stfmygod/esp32-band-pcb/board-a-main/logs/PROMPT_step0_20260529_183550.md

Session 0 complete: board-b-sensor project setup, libraries registered, pogo pin footprint created.
