stfmygod/esp32-band-pcb/board-b-sensor/board-b-sensor.kicad_pcb

## KiCad design board-b-sensor/board-b-sensor.kicad_pcb (2026-06-14)

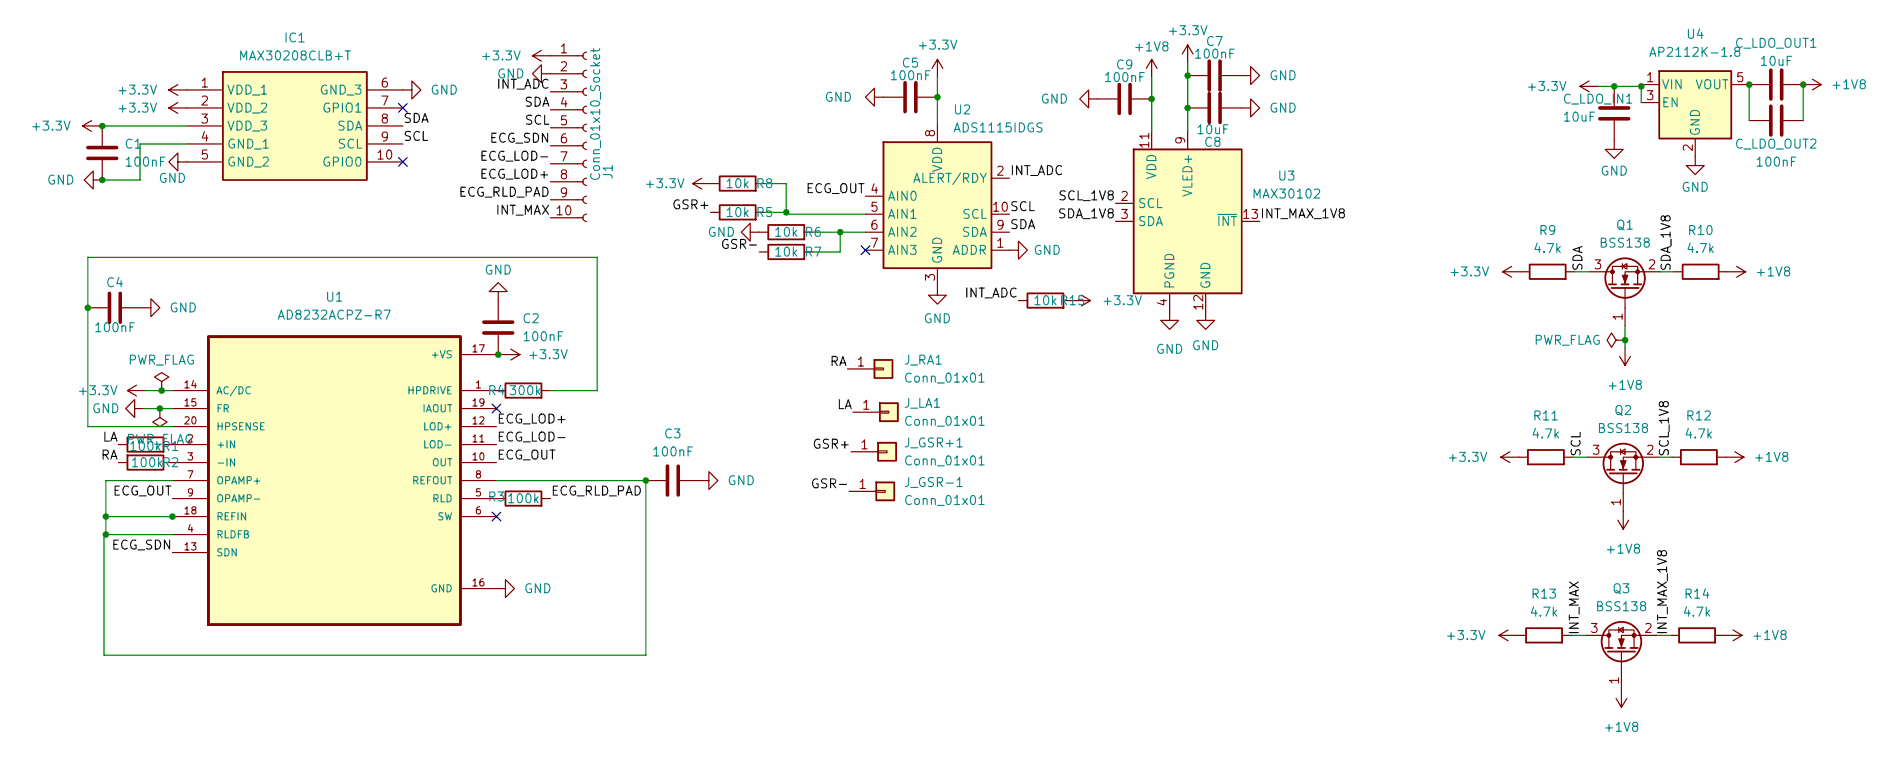
[picture p1: schematic board-b-sensor.kicad_sch]

Parts:
C1, C2, C3, C4, C5, C7, C9: 100nF; C_0402_1005Metric
C8: 10uF; C_0805_2012Metric
C_LDO_IN1: 10uF; C_0805_2012Metric
C_LDO_OUT1: 10uF; C_0805_2012Metric
C_LDO_OUT2: 100nF; C_0402_1005Metric
IC1: MAX30208CLB+T; MAX30208CLBT; Manufacturer_Part_Number MAX30208CLB+T; Mouser Part Number 700-MAX30208CLB+T
J1: Conn_01x10_Socket; FPC-SMD_10P-P0.50_XUNPU_FPC-05F-10PH15
J_GSR+1: Conn_01x01; TestPoint_Pad_D2.0mm
J_GSR-1: Conn_01x01; TestPoint_Pad_D2.0mm
J_LA1: Conn_01x01; TestPoint_Pad_D2.0mm
J_RA1: Conn_01x01; TestPoint_Pad_D2.0mm
Q1, Q2, Q3: BSS138; SOT-23
R1, R2, R3: 100k; R_0402_1005Metric
R4: 300k; R_0402_1005Metric
R5, R6, R7, R8, R15: 10k; R_0402_1005Metric
R9, R10, R11, R12, R13, R14: 4.7k; R_0402_1005Metric
U1: AD8232ACPZ-R7; QFN-20-1EP_4x4mm_P0.5mm_EP2.6x2.6mm
U2: ADS1115IDGS; TSSOP-10_3x3mm_P0.5mm
U3: MAX30102; Maxim_OLGA-14_3.3x5.6mm_P0.8mm
U4: AP2112K-1.8; SOT-23-5

Connections:
+1V8: C9.2, C_LDO_OUT1.2, C_LDO_OUT2.1, Q1.1 (G), Q2.1 (G), Q3.1 (G), R10.2, R12.2, R14.2, U3.11 (VDD)
+3.3V: C1.1, C2.2, C5.2, C7.1, C8.1, C_LDO_IN1.2, IC1.1 (VDD_1), IC1.2 (VDD_2), IC1.3 (VDD_3), J1.1, R8.1, R9.1, R11.1, R13.1, R15.2, U1.14 (AC/DC), U1.17 (+VS), U2.8 (VDD), U3.9 (VLED+), U3.10 (VLED+), U4.1 (VIN), U4.3 (EN)
/ECG_LOD+: J1.8, U1.12 (LOD+)
/ECG_LOD-: J1.7, U1.11 (LOD-)
/ECG_OUT: U1.9 (OPAMP-), U1.10 (OUT), U2.4 (AIN0)
/ECG_RLD_PAD: J1.9, R3.2
/ECG_SDN: J1.6, U1.13 (SDN)
/GSR+: J_GSR+1.1 (Pin_1_1), R5.1
/GSR-: J_GSR-1.1 (Pin_1_1), R7.1
/INT_ADC: J1.3, R15.1, U2.2 (ALERT/RDY)
/INT_MAX: J1.10, Q3.3 (D), R13.2
/INT_MAX_1V8: Q3.2 (S), R14.1, U3.13 (~INT)
/LA: J_LA1.1 (Pin_1_1), R1.1
/RA: J_RA1.1 (Pin_1_1), R2.2
/SCL: IC1.9 (SCL), J1.5, Q2.3 (D), R11.2, U2.10 (SCL)
/SCL_1V8: Q2.2 (S), R12.1, U3.2 (SCL)
/SDA: IC1.8 (SDA), J1.4, Q1.3 (D), R9.2, U2.9 (SDA)
/SDA_1V8: Q1.2 (S), R10.1, U3.3 (SDA)
GND: C1.2, C2.1, C3.2, C4.1, C5.1, C7.2, C8.2, C9.1, C_LDO_IN1.1, IC1.4 (GND_1), IC1.5 (GND_2), IC1.6 (GND_3), J1.2, R6.1, U1.15 (FR), U1.16 (GND), U2.1 (ADDR), U2.3 (GND), U3.4 (PGND), U3.12 (GND), U4.2 (GND)
unnamed: R1.2, U1.2 (+IN)
unnamed: R2.1, U1.3 (-IN)
unnamed: R4.1, U1.1 (HPDRIVE)
unnamed: C4.2, R4.2, U1.20 (HPSENSE)
unnamed: C3.1, U1.4 (RLDFB), U1.7 (OPAMP+), U1.8 (REFOUT), U1.18 (REFIN)
unnamed: R3.1, U1.5 (RLD)
unnamed: R5.2, R8.2, U2.5 (AIN1)
unnamed: R6.2, R7.2, U2.6 (AIN2)
unnamed: C_LDO_OUT1.1, C_LDO_OUT2.2, U4.5 (VOUT)

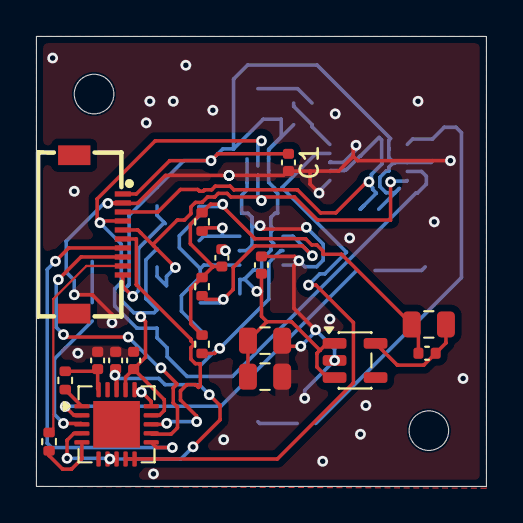
[picture p2: board board-b-sensor.kicad_pcb from above]

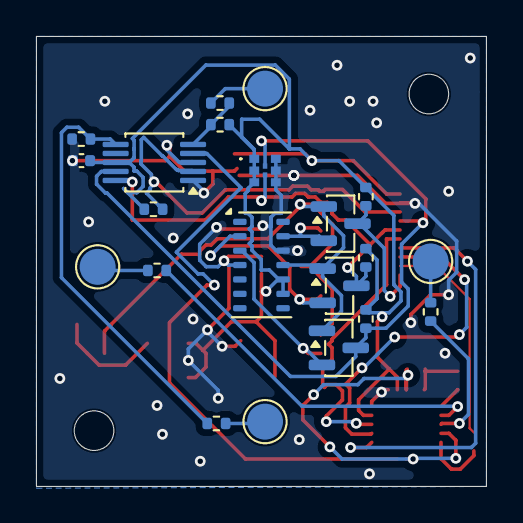
[picture p3: board board-b-sensor.kicad_pcb from below]

Board: 2 copper layers, 25.0 x 25.0 mm, 41 parts (21 on the bottom side), 28 nets.

Other parts of the board:
MountingHole1, MountingHole2: MountingHole_2.2mm_M2
