stfmygod/esp32-band-pcb/board-a-main/board-a-main.kicad_pcb

## KiCad design board-a-main/board-a-main.kicad_pcb (2026-06-02)

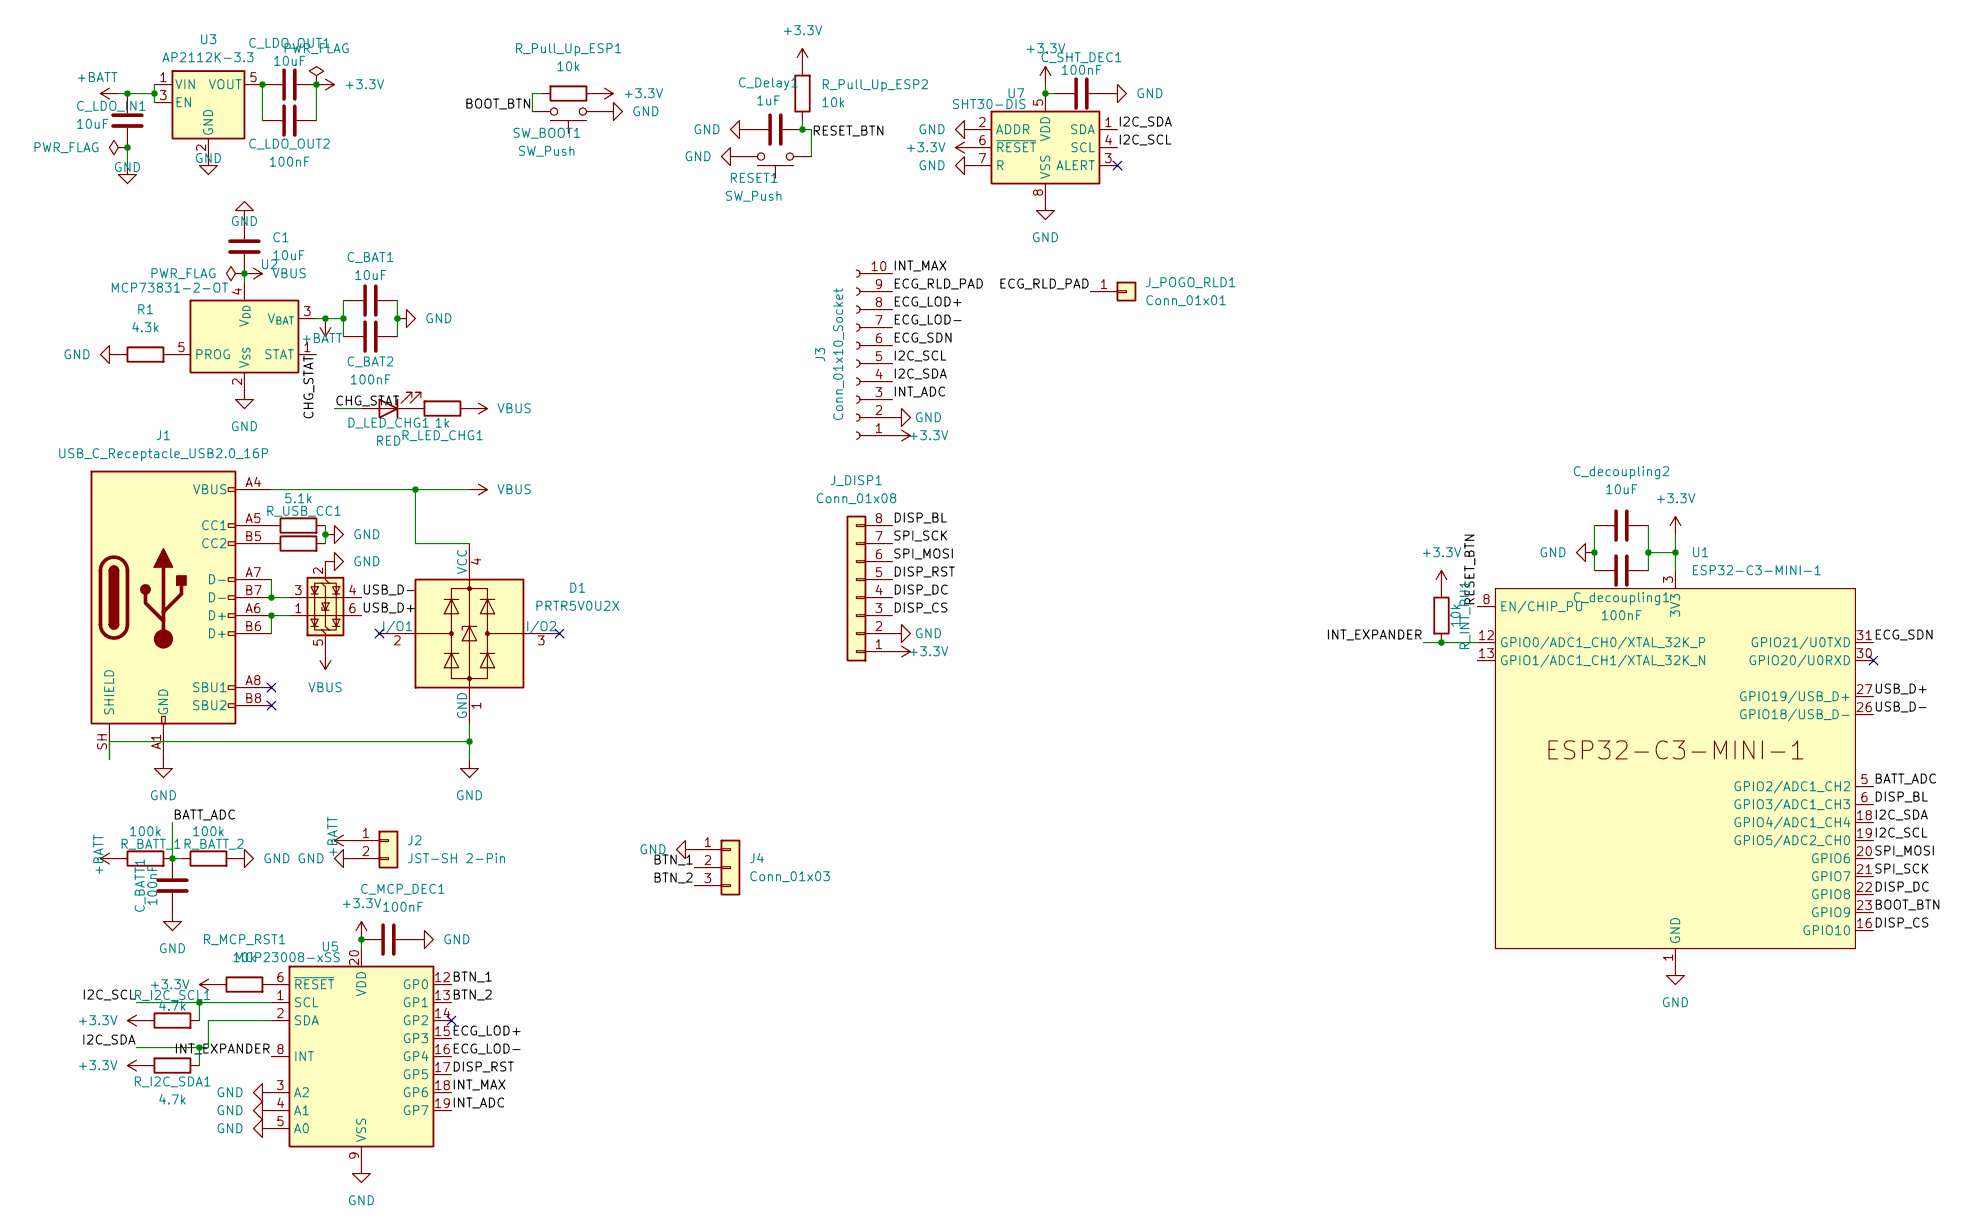
[picture p4: schematic board-a-main.kicad_sch]

Parts:
C1: 10uF; C_0805_2012Metric
C_BAT1: 10uF; C_0805_2012Metric
C_BAT2: 100nF; C_0402_1005Metric
C_BATT1: 100nF; C_0402_1005Metric
C_Delay1: 1uF; C_0805_2012Metric
C_LDO_IN1: 10uF; C_0805_2012Metric
C_LDO_OUT1: 10uF; C_0805_2012Metric
C_LDO_OUT2: 100nF; C_0402_1005Metric
C_MCP_DEC1: 100nF; C_0402_1005Metric
C_SHT_DEC1: 100nF; C_0402_1005Metric
C_decoupling1: 100nF; C_0402_1005Metric
C_decoupling2: 10uF; C_0805_2012Metric
D1: PRTR5V0U2X; SOT-143
D_LED_CHG1: RED; LED_0402_1005Metric
J1: USB_C_Receptacle_USB2.0_16P; USB_C_Receptacle_GCT_USB4105-xx-A_16P_TopMnt_Horizontal
J2: JST-SH 2-Pin; JST_SH_SM02B-SRSS-TB_1x02-1MP_P1.00mm_Horizontal
J3: Conn_01x10_Socket; FPC-SMD_10P-P0.50_XUNPU_FPC-05F-10PH15
J4: Conn_01x03; SolderWire-0.127sqmm_1x03_P3.7mm_D0.48mm_OD1mm
J_DISP1: Conn_01x08; Hirose_FH12-8S-0.5SH_1x08-1MP_P0.50mm_Horizontal
J_POGO_RLD1: Conn_01x01; TestPoint_Pad_D2.0mm
R1: 4.3k; R_0402_1005Metric
RESET1: SW_Push; SW_Push_1P1T_NO_CK_KMR2
R_BATT_1, R_BATT_2: 100k; R_0402_1005Metric
R_I2C_SCL1, R_I2C_SDA1: 4.7k; R_0402_1005Metric
R_INT_PU1: 10k; R_0402_1005Metric
R_LED_CHG1: 1k; R_0402_1005Metric
R_MCP_RST1: 10k; R_0402_1005Metric
R_Pull_Up_ESP1, R_Pull_Up_ESP2: 10k; R_0805_2012Metric
R_USB_CC1, R_USB_CC2: 5.1k; R_0402_1005Metric
SW_BOOT1: SW_Push; SW_Push_1P1T_NO_CK_KMR2
U1: ESP32-C3-MINI-1
U2: MCP73831-2-OT; SOT-23-5
U3: AP2112K-3.3; SOT-23-5
U4: USBLC6-2SC6; SOT-23-6
U5: MCP23008-xSS; SSOP-20_5.3x7.2mm_P0.65mm
U7: SHT30-DIS; Sensirion_DFN-8-1EP_2.5x2.5mm_P0.5mm_EP1.1x1.7mm

Connections:
+3.3V: C_LDO_OUT1.2, C_LDO_OUT2.1, C_MCP_DEC1.1, C_SHT_DEC1.2, C_decoupling1.1, C_decoupling2.1, J3.1, J_DISP1.1, R_I2C_SCL1.1, R_I2C_SDA1.2, R_INT_PU1.1, R_MCP_RST1.1, R_Pull_Up_ESP1.1, R_Pull_Up_ESP2.2, U1.3 (3V3), U5.20 (VDD), U7.5 (VDD), U7.6 (~RESET); also elsewhere on the board
+BATT: C_BAT1.1, C_BAT2.1, C_LDO_IN1.2, J2.1, R_BATT_1.1, U2.3 (V_{BAT}), U3.1 (VIN), U3.3 (EN)
/BATT_ADC: C_BATT1.1, R_BATT_1.2, R_BATT_2.1, U1.5 (GPIO2/ADC1_CH2)
/BOOT_BTN: R_Pull_Up_ESP1.2, SW_BOOT1.2, U1.23 (GPIO9); also elsewhere on the board
/BTN_1: J4.2, U5.12 (GP0)
/BTN_2: J4.3, U5.13 (GP1)
/CHG_STAT: D_LED_CHG1.2 (A), U2.1 (STAT)
/DISP_BL: J_DISP1.8, U1.6 (GPIO3/ADC1_CH3)
/DISP_CS: J_DISP1.3, U1.16 (GPIO10)
/DISP_DC: J_DISP1.4, U1.22 (GPIO8)
/DISP_RST: J_DISP1.5, U5.17 (GP5)
/ECG_LOD+: J3.8, U5.15 (GP3)
/ECG_LOD-: J3.7, U5.16 (GP4)
/ECG_RLD_PAD: J3.9, J_POGO_RLD1.1 (Pin_1_1)
/ECG_SDN: J3.6, U1.31 (GPIO21/U0TXD)
/I2C_SCL: J3.5, R_I2C_SCL1.2, U1.19 (GPIO5/ADC2_CH0), U5.1 (SCL), U7.4 (SCL)
/I2C_SDA: J3.4, R_I2C_SDA1.1, U1.18 (GPIO4/ADC1_CH4), U5.2 (SDA), U7.1 (SDA)
/INT_ADC: J3.3, U5.19 (GP7)
/INT_EXPANDER: R_INT_PU1.2, U1.12 (GPIO0/ADC1_CH0/XTAL_32K_P), U5.8 (INT)
/INT_MAX: J3.10, U5.18 (GP6)
/RESET_BTN: C_Delay1.1, RESET1.1, R_Pull_Up_ESP2.1, U1.8 (EN/CHIP_PU)
/SPI_MOSI: J_DISP1.6, U1.20 (GPIO6)
/SPI_SCK: J_DISP1.7, U1.21 (GPIO7)
/USB_D+: U1.27 (GPIO19/USB_D+), U4.6 (I/O1)
/USB_D-: U1.26 (GPIO18/USB_D-), U4.4 (I/O2)
GND: C1.1, C_BAT1.2, C_BAT2.2, C_BATT1.2, C_Delay1.2, C_LDO_IN1.1, C_MCP_DEC1.2, C_SHT_DEC1.1, C_decoupling1.2, C_decoupling2.2, D1.1 (GND), J1.A1 (GND), J1.A12 (GND), J1.B1 (GND), J1.B12 (GND), J1.SH (SHIELD), J2.2, J3.2, J4.1, J_DISP1.2, R1.1, RESET1.2, R_BATT_2.2, R_USB_CC1.2, R_USB_CC2.2, SW_BOOT1.1, U1.1 (GND), U1.2 (GND), U1.11 (GND), U1.14 (GND), U1.36 (GND), U1.37 (GND), U1.38 (GND), U1.39 (GND), U1.40 (GND), U1.41 (GND), U1.42 (GND), U1.43 (GND), U1.44 (GND), U1.45 (GND), U1.46 (GND), U1.47 (GND), U1.48 (GND), U1.49 (GND), U1.50 (GND), U1.51 (GND), U1.52 (GND), U1.53 (GND), U2.2 (V_{SS}), U3.2 (GND), U4.2 (GND), U5.3 (A2), U5.4 (A1), U5.5 (A0), U5.9 (VSS), U7.2 (ADDR), U7.7 (R), U7.8 (VSS), U7.9 (VSS); also elsewhere on the board
unnamed: D_LED_CHG1.1 (K), R_LED_CHG1.2
unnamed: J1.A5 (CC1), R_USB_CC1.1
unnamed: J1.B5 (CC2), R_USB_CC2.1
unnamed: J1.A6 (D+), J1.B6 (D+), U4.1 (I/O1)
unnamed: J1.A7 (D-), J1.B7 (D-), U4.3 (I/O2)
unnamed: R1.2, U2.5 (PROG)
unnamed: C_LDO_OUT1.1, C_LDO_OUT2.2, U3.5 (VOUT)
unnamed: R_MCP_RST1.2, U5.6 (~RESET)
VBUS: C1.2, D1.4 (VCC), J1.A4 (VBUS), J1.A9 (VBUS), J1.B4 (VBUS), J1.B9 (VBUS), R_LED_CHG1.1, U2.4 (V_{DD}), U4.5 (VBUS)

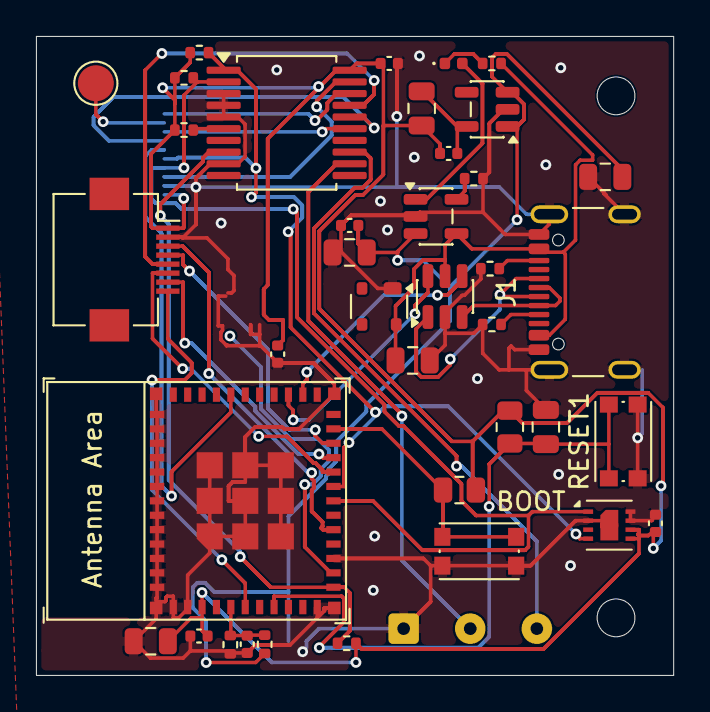
[picture p5: board board-a-main.kicad_pcb from above]

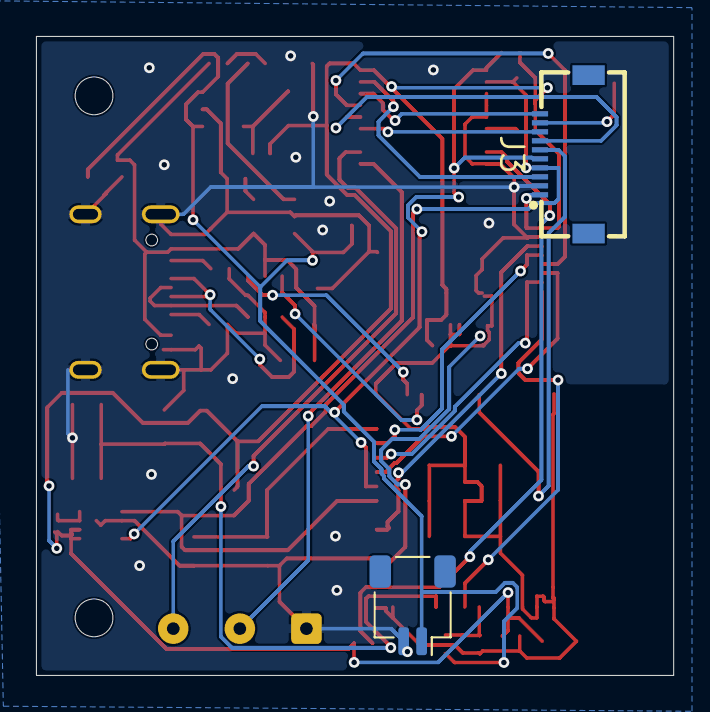
[picture p6: board board-a-main.kicad_pcb from below]

Board: 2 copper layers, 35.4 x 35.5 mm, 43 parts (2 on the bottom side), 35 nets.

Other parts of the board:
BOOT: SW_Push; SW_Push_1P1T_NO_CK_KMR2
C_IMU_DEC1: 100nF; C_0402_1005Metric
REF1, REF2: MountingHole_2.1mm

Their connections:
+3.3V: C_IMU_DEC1.1; also elsewhere on the board
/BOOT_BTN: BOOT.2; also elsewhere on the board
GND: BOOT.1, C_IMU_DEC1.2; also elsewhere on the board
