stfmygod/esp32-band-pcb/(commit log)

2026-05-29 init: PCB project with .gitignore
2026-05-29 session-0: project setup + library registration
    - Created board-b-sensor and board-a-main KiCAD projects
    - Registered custom footprint library (global)
    - Registered symbol libraries: Espressif, MAX30208, AD8232, BMI160, MAX30102 (global)
    - Created Pogo_P75B1_TH footprint (TH, 1.5mm pad, 1.1mm drill)
    - Snapshot session-0-setup for both projects
    [board-a-main.kicad_pcb, board-a-main.kicad_sch, board-b-sensor.kicad_pcb, board-b-sensor.kicad_sch]
2026-05-29 session-1: board-b schematic complete, ERC clean
    All sensor components placed and wired: MAX30102 (HR/SpO2), MAX30208
    (skin temp, I2C addr 0x50), AD8232 (ECG, unity-gain feedback on
    OPAMP-), ADS1115 (4-ch ADC). Decoupling caps, I2C pull-ups, and
    PWR_FLAG symbols added. Fixed MAX30208 lib_symbols sub-symbol format
    for KiCAD 10 SWIG parser compatibility. ERC result: 0 errors, 79
    acceptable warnings (AD8232 off-grid pins, custom footprint lib).
    [board-b-sensor.kicad_sch]
2026-05-30 session-1/2: board-b schematic + PCB progress, update gitignore
    [board-b-sensor.kicad_pcb, board-b-sensor.kicad_sch]
2026-06-02 session-2: board-a progress + board-b schematic updates
    [board-a-main.csv, board-a-main.kicad_pcb, board-a-main.kicad_sch, board-b-sensor.kicad_pcb, board-b-sensor.kicad_sch, smartwatch-board-a_bom.csv, smartwatch-board-a_designators.csv, smartwatch-board-a_positions.csv]
2026-06-14 feat: add Board B sensor schematic and initial PCB layout
    Schematic includes MAX30208, AD8232, ADS1115, MAX30102 with AP2112K-1.8V LDO and BSS138 level shifters for I2C. PCB layout started with component placement on 25x25mm board.
    [board-b-sensor.kicad_pcb, board-b-sensor.kicad_sch]
